lpires211002/CHIDORI-Proyecto-final-de-carrera/PCB PFC/ESP32-C3_SUPERMINI_TH/ESP32-C3_SUPERMINI_TH.step

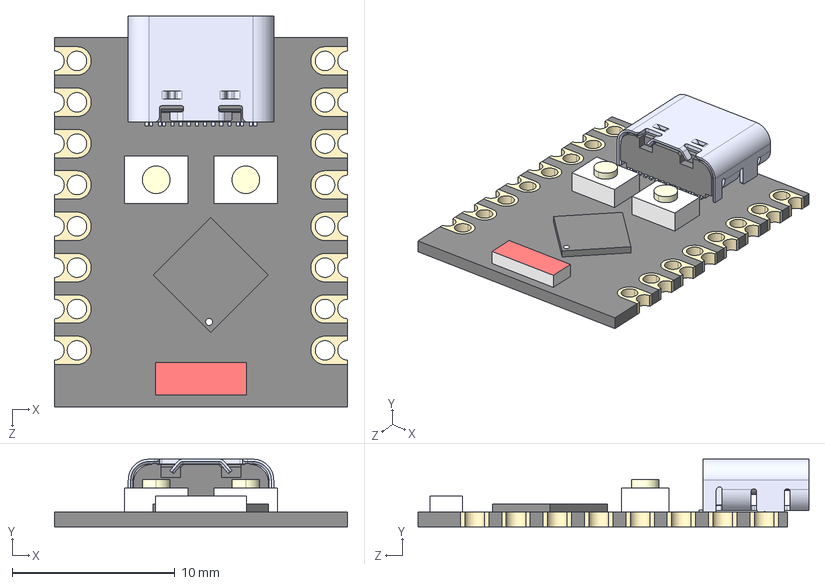
[picture p1: CAD file, 2025-12-10]
PCB PFC/ESP32-C3_SUPERMINI_TH/ESP32-C3_SUPERMINI_TH.step
18.0 x 4.16 x 24.0 mm
Board c3mini
USB C
components (other)^ESP32-C3 SuperMini
