lpires211002/CHIDORI-Proyecto-final-de-carrera/PCB PFC/SJ1-3525N/SJ1-3525N.step

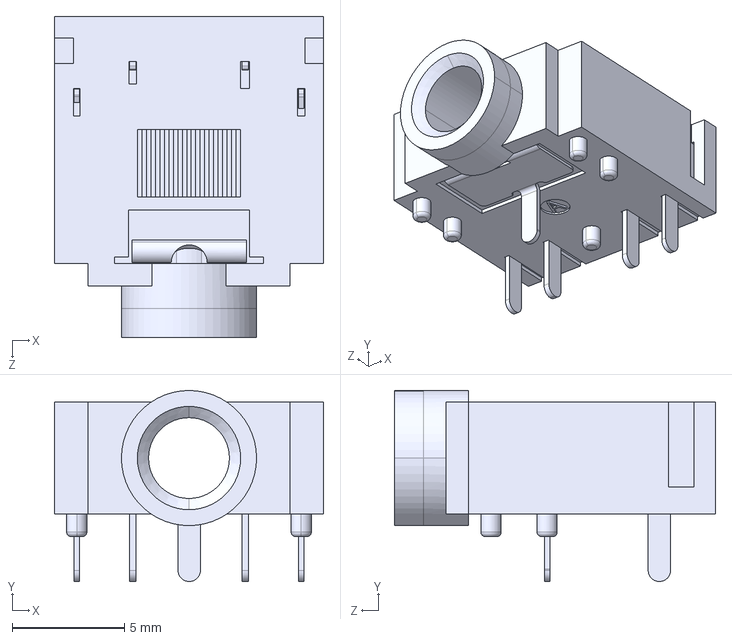
[picture p2: CAD file, 2025-12-10]
PCB PFC/SJ1-3525N/SJ1-3525N.step
12.0 x 8.51 x 14.3 mm
