lpires211002/CHIDORI-Proyecto-final-de-carrera/PCB PFC/PCB PFC.kicad_pcb

## KiCad design PCB PFC/PCB PFC.kicad_pcb (2025-12-11)

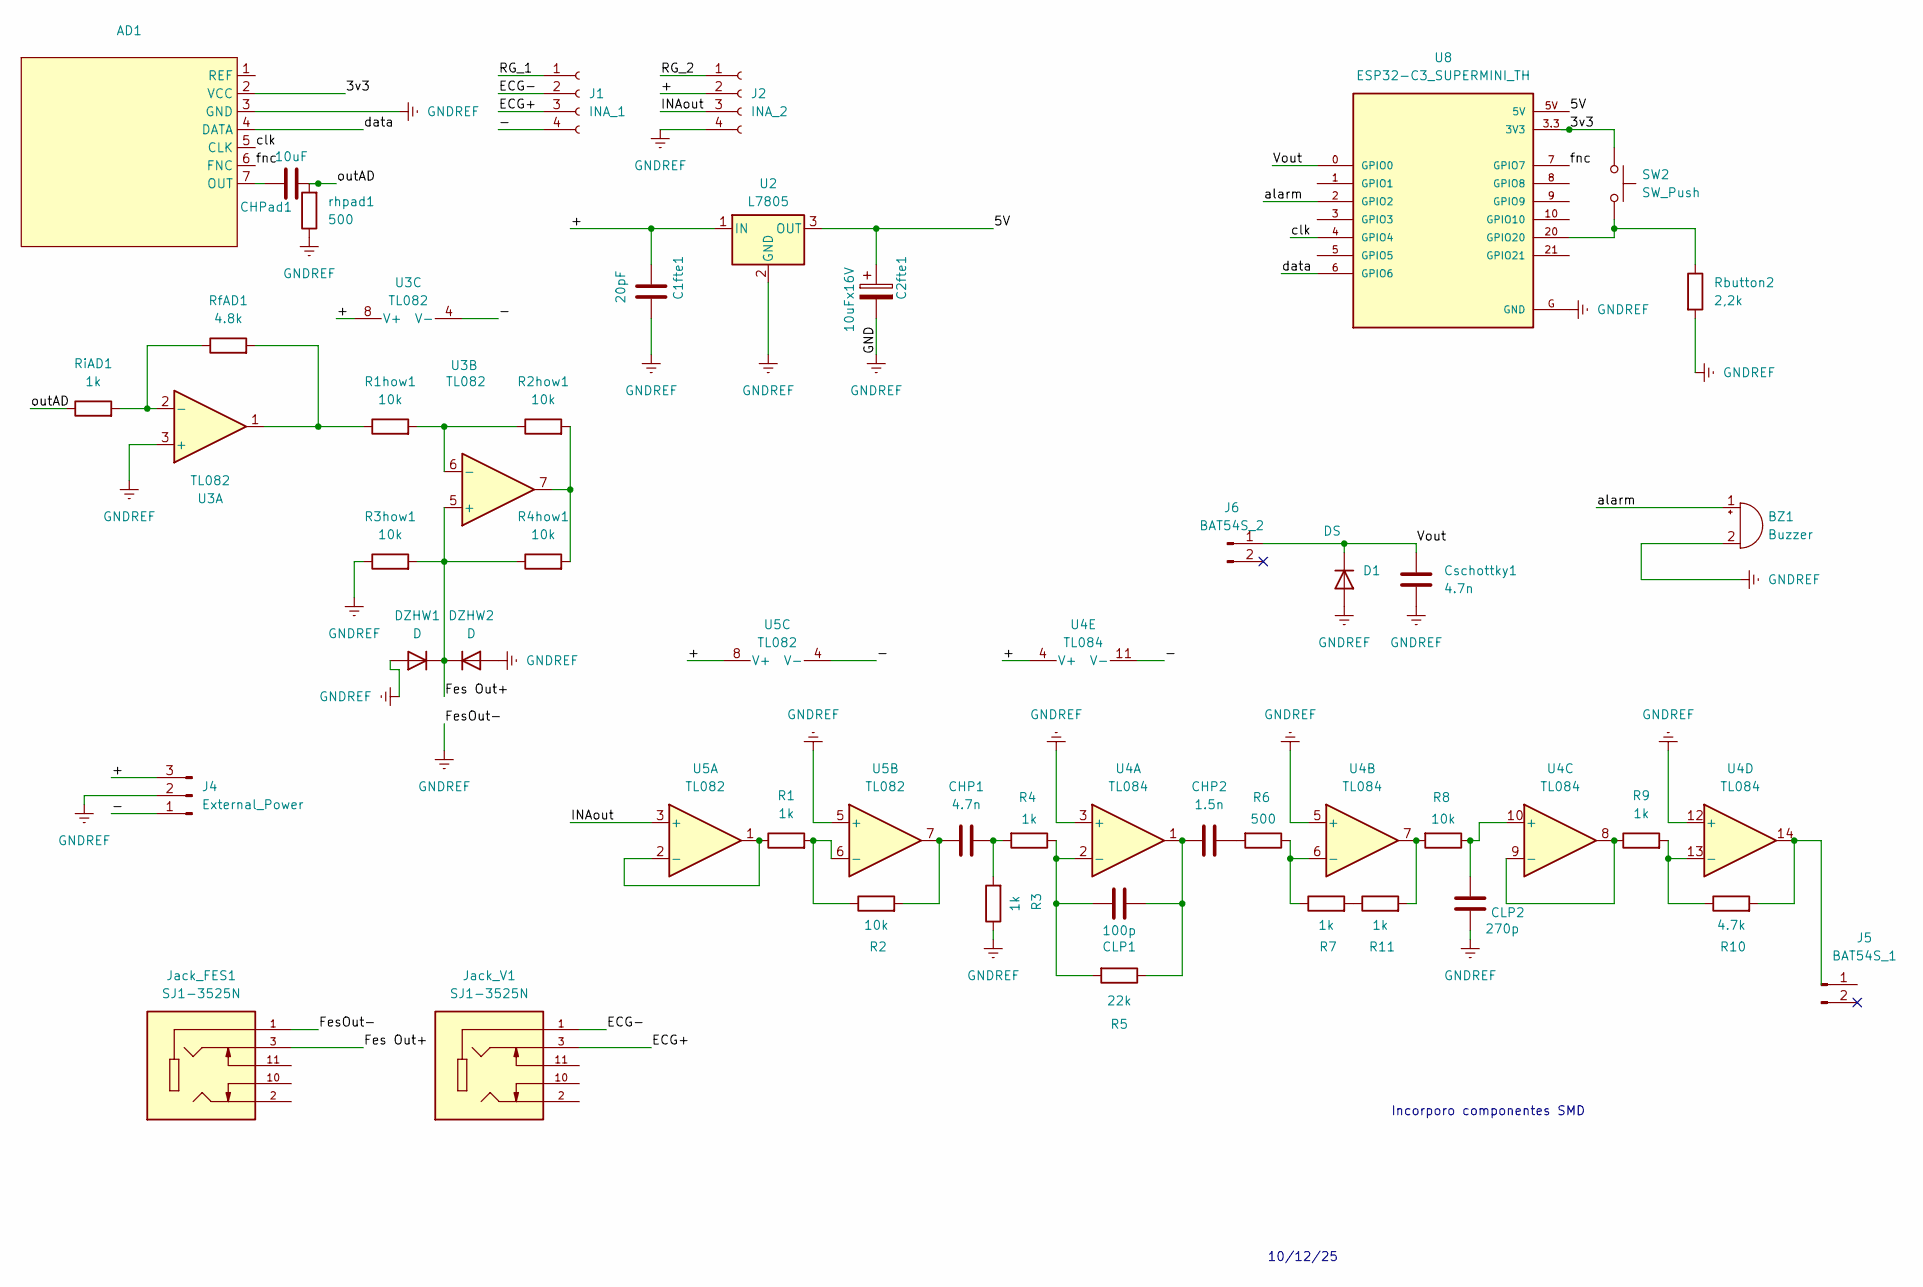
[picture p3: schematic PCB PFC.kicad_sch]

Parts:
AD1: AD9833
BZ1: Buzzer; Buzzer_12x9.5RM7.6
C1fte1: 20pF; C_0603_1608Metric
C2fte1: 10uFx16V; C_0805_2012Metric
CHP1: 4.7n; C_0603_1608Metric
CHP2: 1.5n; C_0603_1608Metric
CHPad1: 10uF; C_0603_1608Metric
CLP1: 100p; C_0603_1608Metric
CLP2: 270p; C_0603_1608Metric
Cschottky1: 4.7n; C_0603_1608Metric
D1: DS; D_DO-35_SOD27_P7.62mm_Horizontal
DZHW1, DZHW2: D; D_DO-35_SOD27_P7.62mm_Horizontal
J1: INA_1; PinSocket_1x04_P2.54mm_Vertical
J2: INA_2; PinSocket_1x04_P2.54mm_Vertical
J4: External_Power; JST_EH_B3B-EH-A_1x03_P2.50mm_Vertical
J5: BAT54S_1; PinSocket_1x02_P2.54mm_Vertical
J6: BAT54S_2; PinSocket_1x02_P2.54mm_Vertical
Jack_FES1: SJ1-3525N; CUI_SJ1-3525N; PARTREV 1.05
Jack_V1: SJ1-3525N; CUI_SJ1-3525N; PARTREV 1.05
R1, R3, R4, R7, R9, R11: 1k; R_0805_2012Metric
R1how1, R2, R2how1, R3how1, R4how1, R8: 10k; R_0805_2012Metric
R5: 22k; R_0805_2012Metric
R6: 500; R_0805_2012Metric
R10: 4.7k; R_0805_2012Metric
Rbutton2: 2,2k; R_0805_2012Metric
RfAD1: 4.8k; R_0805_2012Metric
RiAD1: 1k; R_0805_2012Metric
SW2: SW_Push; SW_PUSH_6mm
U2: L7805; TO-220-3_Vertical
U3, U5: TL082; SOIC-8_3.9x4.9mm_P1.27mm
U4: TL084; SOIC-14_3.9x8.7mm_P1.27mm
U8: ESP32-C3_SUPERMINI_TH; MODULE_ESP32-C3_SUPERMINI_TH
rhpad1: 500; R_0805_2012Metric

Connections:
/3v3: AD1.2 (VCC), SW2.1, U8.3.3 (3V3)
/5V: C2fte1.1, U2.3 (OUT), U8.5V
/+: C1fte1.1, J2.2, J4.3, U2.1 (IN), U3.8 (V+), U4.4 (V+), U5.8 (V+)
/-: J1.4, J4.1, U3.4 (V-), U4.11 (V-), U5.4 (V-)
/ECG+: J1.3, Jack_V1.3
/ECG-: J1.2, Jack_V1.1
/Fes Out+: DZHW1.1 (K), DZHW2.1 (K), Jack_FES1.3, R3how1.2, R4how1.1, U3.5 (+)
/INAout: J2.3, U5.3 (+)
/RG_1: J1.1
/RG_2: J2.1
/Vout: Cschottky1.2, D1.1 (K), J6.1, U8.0 (GPIO0)
/alarm: BZ1.1 (+), U8.2 (GPIO2)
/clk: AD1.5 (CLK), U8.4 (GPIO4)
/data: AD1.4 (DATA), U8.6 (GPIO6)
/fnc: AD1.6 (FNC), U8.7 (GPIO7)
/outAD: CHPad1.2, RiAD1.1, rhpad1.2
GNDREF: AD1.3 (GND), BZ1.2 (-), C1fte1.2, C2fte1.2, CLP2.1, Cschottky1.1, D1.2 (A), DZHW1.2 (A), DZHW2.2 (A), J2.4, J4.2, Jack_FES1.1, R3.1, R3how1.1, Rbutton2.2, U2.2 (GND), U3.3 (+), U4.3 (+), U4.5 (+), U4.12 (+), U5.5 (+), U8.G (GND), rhpad1.1
unnamed: AD1.7 (OUT), CHPad1.1
unnamed: CHP1.1, R2.2, U5.7
unnamed: CHP1.2, R3.2, R4.2
unnamed: CHP2.1, CLP1.2, R5.1, U4.1
unnamed: CHP2.2, R6.2
unnamed: R1how1.1, RfAD1.2, U3.1
unnamed: R2how1.2, R4how1.2, U3.7
unnamed: R10.2, U4.14
unnamed: R7.2, R11.1
unnamed: R8.2, R11.2, U4.7
unnamed: RfAD1.1, RiAD1.2, U3.2 (-)
unnamed: R1how1.2, R2how1.1, U3.6 (-)
unnamed: CLP1.1, R4.1, R5.2, U4.2 (-)
unnamed: R6.1, R7.1, U4.6 (-)
unnamed: CLP2.2, R8.1, U4.10 (+)
unnamed: R9.1, U4.8, U4.9 (-)
unnamed: R9.2, R10.1, U4.13 (-)
unnamed: R1.1, U5.1, U5.2 (-)
unnamed: R1.2, R2.1, U5.6 (-)
unnamed: Rbutton2.1, SW2.2, U8.20 (GPIO20)

Notes on the sheet:
10/12/25
Incorporo componentes SMD

Board: 2 copper layers, 45 parts (0 on the bottom side), 35 nets, no tracks yet.
