lpires211002/CHIDORI-Proyecto-final-de-carrera/Programacion_UI_Micro /PRUEBA_UI/2. Prueba_pakapuncheada/index.html

⚡

# Chidori

🌙

Inactivo

## Control de Mediciones

Monitoreo de bioimpedancia en tiempo real

▶ Iniciar Mediciones 📍 Marcar Evento ↻ Reiniciar ⬇ Exportar

Valor Inicial

Ω

Valor Actual

Ω

Cambio Total

-- %

Velocidad

Ω/min

Tiempo Transcurrido

00:00

min:seg

Eventos Marcados

0

marcadores

## Impedancia vs Tiempo

Módulo de impedancia en tiempo real

📸

## Tasa de Cambio

Derivada de impedancia (Ω/min)

## Línea de Tiempo

Historial de eventos durante la sesión

📋

No hay eventos registrados aún

Los eventos aparecerán aquí cuando los marques durante la medición

⚙️ Configuración de Alarmas ›

Activar sistema de alarmas

Valor absoluto de impedancia

Porcentaje del valor inicial

Diferencia respecto al inicial

Vista previa de zona de alarma:

## Exportar Datos de Sesión

×

📄

### Reporte PDF Completo

Incluye gráficos, estadísticas y datos del paciente

📊

### Datos CSV

Mediciones en formato compatible con Excel

📝

### Archivo de Texto

Formato simple para análisis posterior

Información del Paciente (Opcional)

Nombre Completo

Edad

Sexo

Masculino Femenino

Peso (kg)

Altura (m)

Circunferencia Suprailíaca (cm)

Tiempo desde la última menstruación
