lpires211002/CHIDORI-Proyecto-final-de-carrera/(commit log)

2025-11-12 Primer commit
    [PCB PFC.kicad_pcb, PCB PFC.kicad_sch]
2025-11-26 Rediseño de UI y organización de carpetas
2025-12-10 Agrego jacks de ECG y librerias
    [ESP32-C3_SUPERMINI_TH.step, PCB PFC.kicad_pcb, PCB PFC.kicad_sch, SJ1-3525N.step]
2025-12-13 Purga de .ino y correcciones de Js
